mattphillipseng/GearboxAutomatedDesign/Excel Workbook/SolarImpulseFinalExcel_Group12.xlsx

Sheet: Strengths
Total Flight Time |  |  |  |  |  | Material We Use
Hours given |  | 118 |  |  |  | Material | Steel
Days |  | 4.916666667 |  |  |  | Class | A1-A5 |  | Daily Flight Cycle
Days rounded up |  | 5 |  |  |  | Material Designation | 2.5% Chrome |  | Operation | Hour | Time | RPM | Cycles/Hour | Cycles (cumulative
hours in 5 days |  | 120 |  |  |  | Heat Treatment | Nitrided |  | Take-Off | 1 | 6am-7am | 4000 | 240000 | 240000
 |  |  |  |  |  | Min Surf Hardness | 87.5-90.0 15N |  | Steep Climb | 2 | 7am-6pm | 3180 | 190800 | 430800
Assume Take-off for entire time |  |  |  |  |  | Bending Fatigue Strength Sfb' | 450 | [Mpa] |  | 3 |  | 3180 | 190800 | 621600
Takeoff RPM |  |  | 4000 |  |  | Surface Fatigue Strength Sfc' | 1500 | [Mpa] |  | 4 |  | 3180 | 190800 | 812400
contacts per rev |  |  | 1 |  |  |  |  |  |  | 5 |  | 3180 | 190800 | 1003200
revs per hour |  |  | 240000 |  |  |  |  |  |  | 6 |  | 3180 | 190800 | 1194000
contacts per hour |  |  | 240000 |  |  |  |  |  |  | 7 |  | 3180 | 190800 | 1384800
total contacts |  |  | 28800000 |  |  |  |  |  |  | 8 |  | 3180 | 190800 | 1575600
 |  |  |  |  |  |  |  |  |  | 9 |  | 3180 | 190800 | 1766400
Bending Fatigue Strength |  |  |  |  |  |  |  |  |  | 10 |  | 3180 | 190800 | 1957200
Factor | G2 | G3 | G4 | G5 | Notes |  |  |  |  | 11 |  | 3180 | 190800 | 2148000
KL | 0.94087 | 0.97203 | 0.97203 | 1.01158 | From table |  |  |  |  | 12 |  | 3180 | 190800 | 2338800
TF | 104 | 104 | 104 | 104 | °F |  |  |  | Gliding | 13 | 6pm-10pm | 0 | 0 | 2338800
KT | 0.9096774194 | 0.9096774194 | 0.9096774194 | 0.9096774194 | calculated |  |  |  |  | 14 |  | 0 | 0 | 2338800
KR | 1 | 1 | 1 | 1 | 99.00% |  |  |  |  | 15 |  | 0 | 0 | 2338800
Sfb | 465.4325007 | 480.843731 | 480.843731 | 500.4069377 | MPa MAX |  |  |  |  | 16 |  | 0 | 0 | 2338800
 |  |  |  |  |  |  |  |  | Steady Altitude | 17 | 10pm-6am | 2555 | 153300 | 2492100
Surface Fatigue Strength |  |  |  |  |  |  |  |  |  | 18 |  | 2555 | 153300 | 2645400
Factor | G2 | G3 | G4 | G5 | Notes |  |  |  |  | 19 |  | 2555 | 153300 | 2798700
CL | 0.84537 | 0.88660 | 0.88660 | 0.93894 | From table |  |  |  |  | 20 |  | 2555 | 153300 | 2952000
TF | 104 | 104 | 104 | 104 | °F |  |  |  |  | 21 |  | 2555 | 153300 | 3105300
CT | 0.9096774194 | 0.9096774194 | 0.9096774194 | 0.9096774194 | calculated |  |  |  |  | 22 |  | 2555 | 153300 | 3258600
CR | 1 | 1 | 1 | 1 | 99.00% |  |  |  |  | 23 |  | 2555 | 153300 | 3411900
CH | 1 | 1 | 1 | 1 | hardness factor |  |  |  |  | 24 |  | 2555 | 153300 | 3565200
Sfc | 1393.959405 | 1461.950127 | 1461.950127 | 1548.258392 | MPa MAX |  |  |  |  |  |  |  | Avg cycle/hour | 148550 | each tooth hit once in a revolution
 |  |  |  |  |  |  |  |  |  |  |  |  | x2000 hrs | 297100000
 |  |  |  |  |  |  |  |  |  |  |  |  | TOTAL CYCLES | 297100000 | 118840000 | 118840000 | 37137500
 |  |  |  |  |  |  |  |  |  |  |  |  |  | G2 | G3 | G4 | G5
 |  |  |  |  |  |  |  |  |  |  |  |  | Num Teeth | 18 | 45 | 20 | 64 | 8

Sheet: Gear Specs
Gear | 2 | 3 | 4 | 5
Teeth | 18 | 45 | 20 | 64
Module (mm) | 3 | 3 | 3 | 3
Face Width (mm) | 24 | 24 | 35 | 35
Pressure Angle | 20 | 20 | 20 | 20
Bending Safety Factor | 2.362 | 2.284 | 1.525 | 1.459
Surface Saftey Factor | 1.49 | 3.371 | 1.083 | 3.03
Pitch Diam | 54 | 135 | 60 | 192
Outer Diam | 60 | 141 | 66 | 198
total size | 295.5

Sheet: K_L and C_L
KL
x | y | CL
10000000 | 1.05 | 1.6042
10000000000 | 0.8125
Textbook Table
"12-24" | p756
 |  | This section was made form the textbook graphs to automate finding KL and CL, and so we can put this into MATLAB. ALSO, i did this before i realized there were equations on the charts in the book. I don't know how i didn't see that. The values they give are almost identical, so not a big deal.
CL
x | y
10000000 | 1 | KL
10000000000 | 0.69 | 1.7233
Textbook Table
"12-26" | p759

Sheet: Shafts
Forces |  |  |  | (input shaft)
 |  |  |  | Shaft 1 | Value | Units | Note
Gear 2 | Value | Units | Note | Total effective length | 70 | mm
 |  |  |  | dist from left bearing to gear | 27.5 | mm |  | Values
Volume | 5.276636e-05 | m3 |  | dist from gear to right bearing | 42.5 | mm |  | Steel density | 7.8 | Mg/m^3
Mass | 0.41 | kg
Weight | 4.037576334 | N | Upper bound | Right bearing reaction | 1102.606438 | N
Pitch diameter | 54 | mm |  | Left bearing reaction | 1704.028131 | N
 |  |  |  |  |  |  |  | Conversion factors
Power | 29827.99488 | W |  |  |  |  |  | mm^3 to m^3 | 1000000000
RPM | 4000 | rev/min |  |  |  |  |  | hp to W | 745.699872
Omega | 418.8790205 | rad/s |  |  |  |  |  | RPM to rad/s | 0.1047197551
Torque | 71.20909242 | N m
Wt | 2637.373793 | N
Wr | 959.9255573
W | 2806.634568
Gear 3 | Value | Units | Note | Shaft 2 | Value | Units | Note
Volume | 0.00033861109 | m3 |  | Total effective length | 206 | mm
Mass | 2.641166502 | kg |  | dist from left bearing to left gear | 35 | mm
Weight | 25.90984338 | N | Upper bound - without hollow gear | distance from left gear to right gear | 130.5 | mm
Pitch diameter | 135 | mm |  | distance from right gear to right bearing | 40.5 | mm
Power | 29827.99488 | W |  | Right bearing reaction | 5550.256103
RPM | 1600 | rev/min |  | Left bearing reaction | 3571.306244
Omega | 167.5516082 | rad/s
Torque | 178.022731 | N m
Wt | 2637.373793 | N
Wr | 959.9255573
W | 2806.634568
Gear 4 | Value | Units
Volume | 9.546012e-05 | m3
Mass | 0.744588936 | kg
Weight | 7.304417462 | N | Upper bound - without hollow gear
Pitch diameter | 60 | mm
Power | 29827.99488 | W
RPM | 1600 | rev/min
Omega | 167.5516082 | rad/s
Torque | 178.022731 | N m
Wt | 5934.091035 | N
Wr | 2159.832504
W | 6314.927779
 |  |  |  | Output shaft
Gear 5 | Value | Unit | Note | Shaft 3 | Value | Units | Note
Volume | 0.00100338005 | m3 |  | Total effective length | 91 | mm
Mass | 7.82636439 | kg |  | dist from left bearing to gear | 53 | mm
Weight | 76.77663467 | N | Upper bound - without hollow gear | dist from gear to right bearing | 38 | mm
Pitch diameter | 192 | mm
 |  |  |  | Right bearing reaction | 3677.92497 | N
Power | 29827.99488 | W |  | Left bearing reaction | 2637.002809 | N
RPM | 500 | rev/min
Omega | 52.35987756 | rad/s
Torque | 569.6727393 | N m
Wt | 5934.091035 | N
Wr | 2159.832504 | N
W | 6314.927779 | N

Sheet: Shafts Diagrams
 |  |  |  | Steel with
Shaft 1
 |  |  |  | At stress conc. 1 |  |  |  |  | At Max moment |  |  |  |  | At stress conc. 2 |  |  |  |  | At stress conc. 3
 |  |  |  | x | = | 15 |  |  | x | = | 27.5 |  |  | x | = | 40 |  |  | x | = | 55
 |  |  |  | Parameters |  |  |  |  | Parameters |  |  |  |  | Parameters |  |  |  |  | Parameters
 |  |  |  | kf | = | 1.299 |  |  | kf | = | 1 |  |  | kf | = | 1.368 |  |  | kf | = | 1.1104
 |  |  |  | Ma | = | 25560.42196 |  |  | Ma | = | 46860.7736 |  |  | Ma | = | 33078.19313 |  |  | Ma | = | 16539.09656
 | x | (V) | Note | kfsm | = | 1.138 |  |  | kfsm | = | 1 |  |  | kfsm | = | 1.138 |  |  | kfsm | = | 1.253
 | 0 | 1704.028131 |  | Tm | = | 71.20909242 |  |  | Tm | = | 71.20909242 |  |  | Tm | = | 0 |  |  | Tm | = | 0
 | 15 | 1704.028131 | Stress Concentration | Se | = | 562 |  |  | Se | = | 562 |  |  | Se | = | 562 |  |  | Se | = | 562
 | 27.5 | 1704.028131 |  | Sut | = | 1124 |  |  | Sut | = | 1124 |  |  | Sut | = | 1124 |  |  | Sut | = | 1124
 | 27.5 | -1102.606438
 | 40 | -1102.606438 |  |  | d | = | 20 |  |  | d | = | 25 |  |  | d | = | 25 |  |  | d | = | 20
 | 55 | -1102.606438 |  |  | D/d | = | 1.25 |  |  | D/d | = | 0 |  |  | D/d | = | 1.2 |  |  | D/d | = | 1.5
 | 70 | -1102.606438 |  |  | r/d | = | 0.25 |  |  | r/d | = | 0 |  |  | r/d | = | 0.2 |  |  | r/d | = | 0.5
 |  |  |  |  | Kt_bend | = | 1.325 |  |  | Kt_bend | = | 0 |  |  | Kt_bend | = | 1.4 |  |  | Kt_bend | = | 1.12
 |  |  |  |  | Kt_tors | = | 1.15 |  |  | Kt_tors | = | 0 |  |  | Kt_tors | = | 1.15 |  |  | Kt_tors | = | 1.275
 |  |  |  |  | yields… |  |  |  |  | yields… |  |  |  |  | yields… |  |  |  |  | yields…
 |  |  |  |  | Nf | = | 8.869917651 |  |  | Nf | = | 12.27771189 |  |  | Nf | = | 12.71932927 |  |  | Nf | = | 16.04614865
 |  |  |  |  |  |  | note
 |  |  |  |  | Steel option | AISI 1050 | Quench and temper @ 400deg F
 |  |  |  |  | SUT | 1124
 | x | M | Note |  | q | 0.92
 | 0 | 0 |  |  | Se | 562 | Sut < 1400 => Se = 0.5Sut
 | 15 | 25560.42196
 | 27.5 | 46860.7736 |  |  | Se | 375.2080657
 | 40 | 33078.19313
 | 55 | 16539.09656 |  |  | Cload | 1
 | 70 | 0 |  |  | Csize | 0.8891641518
 |  |  |  |  | Csurf | 0.9224216765
 |  |  |  |  | Ctemp | 1
 |  |  |  |  | Creliab | 0.814
 | x | T | Note
 | 0 | 71.20909242
 | 15 | 71.20909242
 | 27.5 | 71.20909242
 | 27.5 | 0
 | 40 | 0
 | 55 | 0
 | 70 | 0
Shaft 2
 |  |  |  |  | At stress conc. 1 |  |  |  |  | At stress conc. 2 |  |  |  |  | At stress conc. 3 |  |  |  |  | At Max moment |  |  |  | At stress conc. 4
Left bearing force |  | 3571.306244 |  |  | x | = | 22.5 |  |  | x | = | 47.5 |  |  | x | = | 147.5 |  |  | x | = | 165.5 |  | x | = | 183.5
left gear force |  | 2806.634568 |  |  | Parameters |  |  |  |  | Parameters |  |  |  |  | Parameters |  |  |  |  | Parameters |  |  |  | Parameters
right gear force |  | 6314.927779 |  |  | kf | = | 1.414 |  |  | kf | = | 1.46 |  |  | kf | = | 1.46 |  |  | kf | = | 1 |  | kf | = | 1.414
right bearing force |  | 5550.256103 |  |  | Ma | = | 80354.39049 |  |  | Ma | = | 134554.1145 |  |  | Ma | = | 211021.282 |  |  | Ma | = | 224785.3722 |  | Ma | = | 124880.7623
 |  |  |  |  | kfsm | = | 1.1288 |  |  | kfsm | = |  |  |  | kfsm | = | 1.138 |  |  | kfsm | = | 1 |  | kfsm | = | 1.1288
 |  |  |  |  | Tm | = | 0 |  |  | Tm | = | 178.022731 |  |  | Tm | = | 178.022731 |  |  | Tm | = | 0 |  | Tm | = | 356.0454621
 | x | V |  |  | Se' | = | 562 |  |  | Se' | = | 562 |  |  | Se' | = | 562 |  |  | Se' | = | 562 |  | Se' | = | 562
 | 0 | 3571.306244 |  |  | Sut | = | 1124 |  |  | Sut | = | 1124 |  |  | Sut | = | 1124 |  |  | Sut | = | 1124 |  | Sut | = | 1124
 | 22.5 | 3571.306244
 | 35 | 3571.306244 |  |  |  | d | = | 32 |  |  | d | = | 37 |  |  | d | = | 37 |  |  | d | = | 42 |  | d | = | 32
 | 35 | 764.6716755 |  |  |  | D/d | = | 1.15625 |  |  | D/d | = | 1.135 |  |  | D/d | = | 1.135 |  |  | D/d | = | 1 |  | D/d | = | 1.15625
 | 47.5 | 764.6716755 |  |  |  | r/d | = | 0.15625 |  |  | r/d | = | 0.135 |  |  | r/d | = | 0.135 |  |  | r/d | = | 0 |  | r/d | = | 0.15625
 | 147.5 | 764.6716755 |  |  |  | Kt_bend | = | 1.45 |  |  | Kt_bend | = | 1.5 |  |  | Kt_bend | = | 1.5 |  |  | Kt_bend | = | 1 |  | Kt_bend | = | 1.45
 | 165.5 | 764.6716755 |  |  |  | Kt_tors | = | 1.14 |  |  | Kt_tors | = | 1.15 |  |  | Kt_tors | = | 1.15 |  |  | Kt_tors | = | 1 |  | Kt_tors | = | 1.14
 | 165.5 | -5550.256103 |  |  |  | yields… |  |  |  |  | yields… |  |  |  |  | yields… |  |  |  |  | yields… |  |  |  | yields…
 | 183.5 | -5550.256103 |  |  |  | Nf | = | 9.56920341 |  |  | Nf | = | 8.555397767 |  |  | Nf | = | 5.454394344 |  |  | Nf | = | 10.93615601 |  | Nf | = | 6.154134694
 | 206 | -5550.256103
 | 206 | 0 |  |  |  |  |  | note
 |  |  |  |  |  | Steel option | AISI 1050 | Quench and temper @ 400deg F
 | x | M |  |  |  | SUT | 1124
 | 0 | 0 |  |  |  | q | 0.92
 | 22.5 | 80354.39049 |  |  |  | Se | 562 | Sut < 1400 => Se = 0.5Sut
 | 35 | 124995.7185
 | 47.5 | 134554.1145
 | 147.5 | 211021.282 |  |  |  | Se | 337.975312
 | 165.5 | 224785.3722
 | 183.5 | 124880.7623 |  |  |  | Cload | 1
 | 206 | -1.309672371e-10 |  |  |  | Csize | 0.8495370161
 |  |  |  |  |  | Csurf | 0.8696448922
 |  |  |  |  |  | Ctemp | 1
 | x | T |  |  |  | Creliab | 0.814
 | 0 | 0
 | 22.5 | 0
 | 35 | 0
 | 35 | 178.022731
 | 47.5 | 178.022731
 | 147.5 | 178.022731
 | 165.5 | 178.022731
 | 165.5 | 356.0454621
 | 183.5 | 356.0454621
 | 206 | 356.0454621
 | 206 | 0
Shaft 3
Left bearing force |  | 2637.002809
right bearing force |  | 3677.92497
gear force |  | 6314.927779
 |  |  |  |  | At stress conc. 1 |  |  |  |  | At stress conc. 2 |  |  |  |  | At Max moment |  |  |  |  | At stress conc. 3
 |  |  |  |  | x | = | 20 |  |  | x | = | 35 |  |  | x | = | 53 |  |  | x | = | 71
 |  |  |  |  | Parameters |  |  |  |  | Parameters |  |  |  |  | Parameters |  |  |  |  | Parameters
 |  |  |  |  | kf | = | 1.1656 |  |  | kf | = | 1.414 |  |  | kf | = | 1 |  |  | kf | = | 1.345
 |  |  |  |  | Ma | = | 52740.05618 |  |  | Ma | = | 92295.09831 |  |  | Ma | = | 139761.1489 |  |  | Ma | = | 73558.4994
 |  |  |  |  | kfsm | = | 1.092 |  |  | kfsm | = | 1.138 |  |  | kfsm | = | 1 |  |  | kfsm | = | 1.161
 |  |  |  |  | Tm | = | 0 |  |  | Tm | = | 0 |  |  | Tm | = | 0 |  |  | Tm | = | 569.6727393
 |  |  |  |  | Se | = | 562 |  |  | Se | = | 562 |  |  | Se | = | 562 |  |  | Se | = | 562
 |  |  |  |  | Sut | = | 1124 |  |  | Sut | = | 1124 |  |  | Sut | = | 1124 |  |  | Sut | = | 1124
 |  |  |  |  |  | d | = | 25 |  |  | d | = | 35 |  |  | d | = | 30 |  |  | d | = | 25
 |  |  |  |  |  | D/d | = | 1.4 |  |  | D/d | = | 1.16 |  |  | D/d | = |  |  |  | D/d | = | 1.2
 |  |  |  |  |  | r/d | = | 0.4 |  |  | r/d | = | 0.16 |  |  | r/d | = |  |  |  | r/d | = | 0.2
 | x | V |  |  |  | Kt_bend | = | 1.18 |  |  | Kt_bend | = | 1.45 |  |  | Kt_bend | = |  |  |  | Kt_bend | = | 1.375
 | 0 | 2637.002809 |  |  |  | Kt_tors | = | 1.1 |  |  | Kt_tors | = | 1.15 |  |  | Kt_tors | = |  |  |  | Kt_tors | = | 1.175
 | 20 | 2637.002809 |  |  |  | yields… |  |  |  |  | yields… |  |  |  |  | yields… |  |  |  |  | yields…
 | 35 | 2637.002809 |  |  |  | Nf | = | 9.932811365 |  |  | Nf | = | 12.83862091 |  |  | Nf | = | 7.54952436 |  |  | Nf | = | 6.160794592
 | 53 | 2637.002809
 | 53 | -3677.92497
 | 71 | -3677.92497 |  |  |  |  |  | note
 | 91 | -3677.92497 |  |  |  | Steel option | AISI 1050 | Quench and temper @ 400deg F
 | 91 | 0 |  |  |  | SUT | 1124
 |  |  |  |  |  | q | 0.92
 |  |  |  |  |  | Se | 562 | Sut < 1400 => Se = 0.5Sut
 |  |  |  |  |  | Se | 398.0543683
 | x | M |  |  |  | Cload | 1
 | 0 | 0 |  |  |  | Csize | 0.8701250541
 | 20 | 52740.05618 |  |  |  | Csurf | 1 | >1
 | 35 | 92295.09831 |  |  |  | Ctemp | 1
 | 53 | 139761.1489 |  |  |  | Creliab | 0.814
 | 71 | 73558.4994
 | 91 | 0
 | x | T
 | 0 | 0
 | 20 | 0
 | 35 | 0
 | 53 | 0
 | 53 | 569.6727393
 | 71 | 569.6727393
 | 91 | 569.6727393

Sheet: Bearings
 | Ball bearing: |  |  |  |  |  |  |  |  | K_R | = | 0.21 | 99% reliab
 |  |  |  |  |  |  |  |  |  | L_P | =
 | Roller Bearing:
 | FOR ROLLER BEARINGS
 |  | Bearings Shaft 1 | Note | Bearings Shaft 2 | Note | Bearings Shaft 3 (normal one) | Note | Bearings Shaft 3 (thrust bearing) | Note
input | Reaction 1 | 1.7040281 |  | 5.55
input | Reaction 2
 | Max Reaction | 1.7040281 |  | 5.55 |  | 2.637 | reaction at left | 3.677 | reaction at right
input | C | 28.5 | KN | 45.1 | KN | 38.1 | newtons | 74.1 | newtons
 | F_radial | 1.7040281 | from max reaction | 5.55 | from max reaction | 2.637 | from max reaction | 3.677 | max reaction
 | F_a (thrust) | 0 | no thrust | 0 | no thrust | 0 | no thrust | 6.672
input | X |  |  |  |  |  |  | 0.4
 | V | 1 |  | 1 |  | 1 |  | 1
input | Y |  |  |  |  |  |  | 2
calculation | P | 1.7040281 |  | 5.55 |  | 2.637 |  | 14.8148
 | K_R | 0.21 |  | 1 |  | 0.21 |  | 1.07
 | L_P minimum | 1782.0 |  | 714.0 |  | 222.6 |  | 222.6
 | L_P | 2512.540018 |  | 1078.810577 |  | 1542.654893 |  | 228.9769826 | should be at least L_P min
 | (20mm)Cylindrical Roller single row NUP204ECP |  |  | (32mm)Tappered Roller single row 320/32X |  | (25mm)Tappered Roller single row 30205 |  | (25mm) Tappered Roller single row 32305
 | C_0 = 22KN |  |  | C_0 = 45.1KN |  | C_0 = 33.5KN |  | C_0 = 63KN
 | S_L =19000 |  |  | S_L=11000 |  | S_L=13000 |  | S_L=12000
 | Cycles for each bearing
 |  | Shaft 1 | Shaft 2 |  | Shaft 3
 | 2000 hrs | 297000000 | 119000000 | 119000000 | 37100000
 | 6000 hrs | 1782000000 | 714000000 | 714000000 | 222600000
 | 6000 hrs in millions of cycles | 1782.0 | 714.0 | 714.0 | 222.6
 | from strengths sheet
