mattphillipseng/GearboxAutomatedDesign/CAD 393/G4.SLDASM

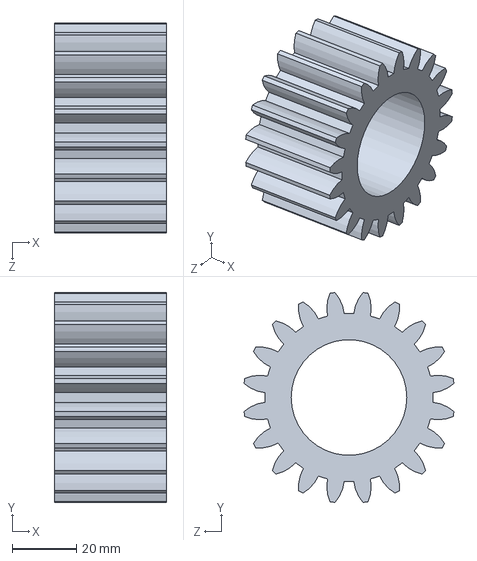
[picture p20: CAD file, 2018-02-15]
CAD 393/G4.SLDASM
35.0 x 65.4 x 65.4 mm
