mattphillipseng/GearboxAutomatedDesign/CAD 393/G3.SLDASM

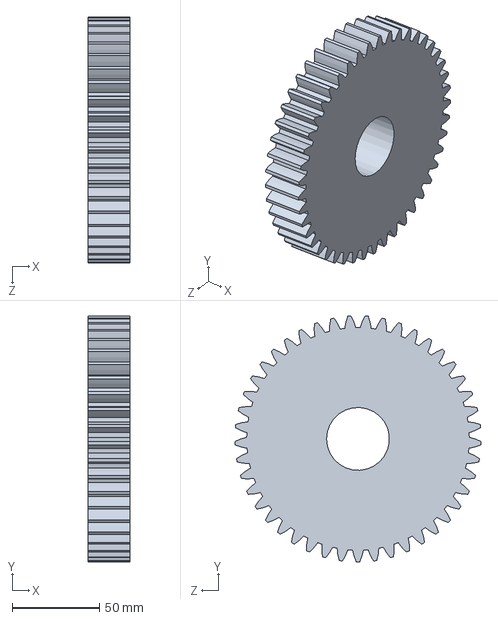
[picture p21: CAD file, 2018-02-15]
CAD 393/G3.SLDASM
24.0 x 140.9 x 141.0 mm
