mattphillipseng/GearboxAutomatedDesign/CAD 393/G5.SLDASM

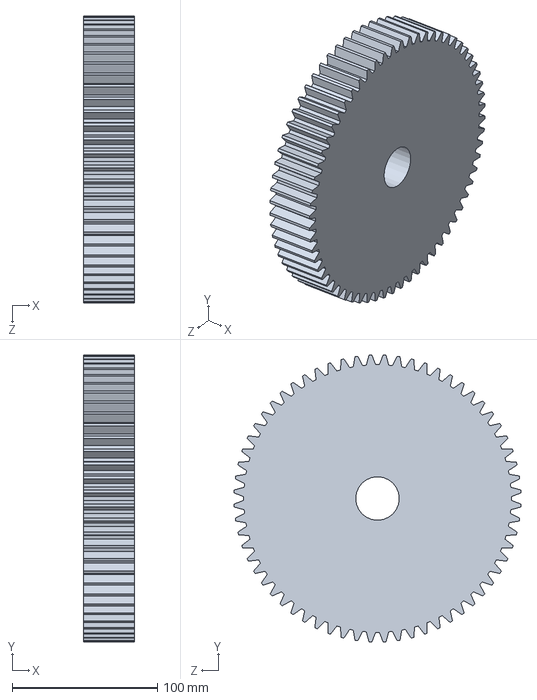
[picture p22: CAD file, 2018-02-15]
CAD 393/G5.SLDASM
35.0 x 197.8 x 197.8 mm
