mattphillipseng/GearboxAutomatedDesign/CAD 393/G2.SLDASM

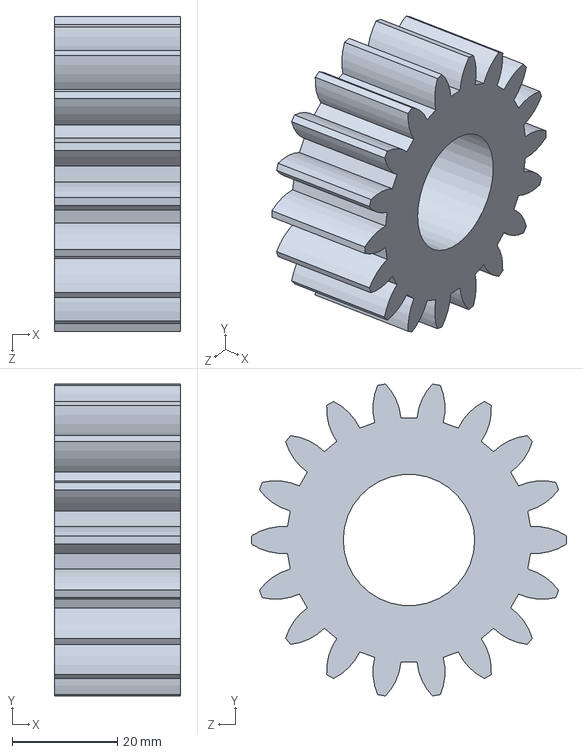
[picture p23: CAD file, 2018-02-15]
CAD 393/G2.SLDASM
24.0 x 59.3 x 60.0 mm
