mattphillipseng/GearboxAutomatedDesign/CAD 393/FULL2.SLDASM

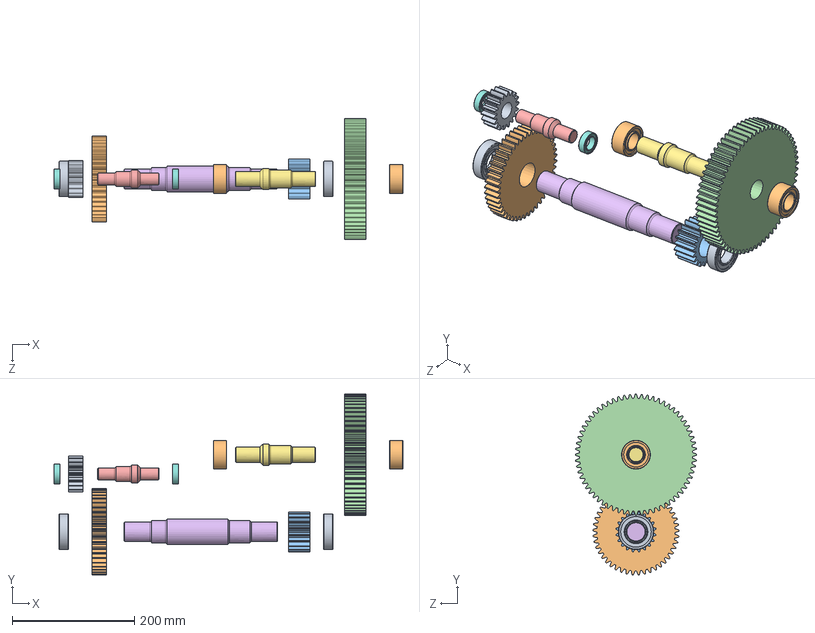
[picture p24: CAD file, 2018-02-15]
CAD 393/FULL2.SLDASM
570.0 x 295.4 x 198.0 mm
G2
G3
G4
G5
Shaft1
Shaft2
Shaft3
AFBMA 20.1 - 38-20 - 20,SI,NC,20 x 2
AFBMA 20.1 - 20-32 - 16,SI,NC,16 x 2
AFBMA 20.1 - 40-25 - 16,SI,NC,16 x 2
