mattphillipseng/GearboxAutomatedDesign/CAD 393/Shaft1.SLDPRT

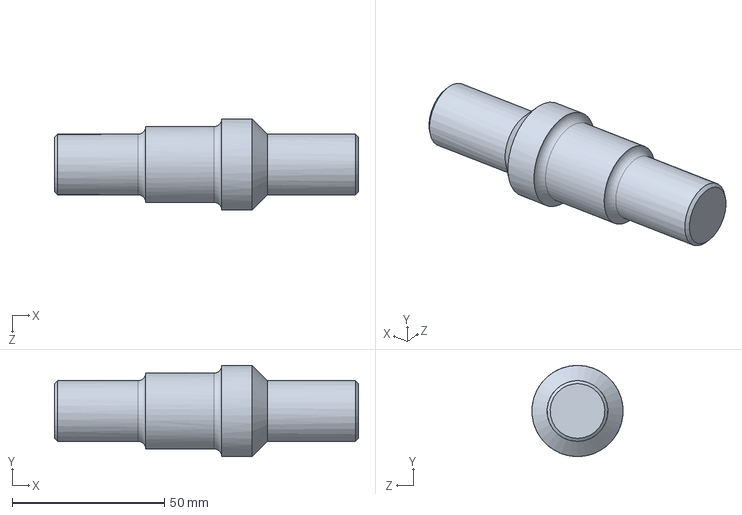
[picture p25: CAD file, 2018-02-15]
CAD 393/Shaft1.SLDPRT
100.0 x 30.0 x 30.0 mm
