mattphillipseng/GearboxAutomatedDesign/CAD 393/Shaft3.SLDPRT

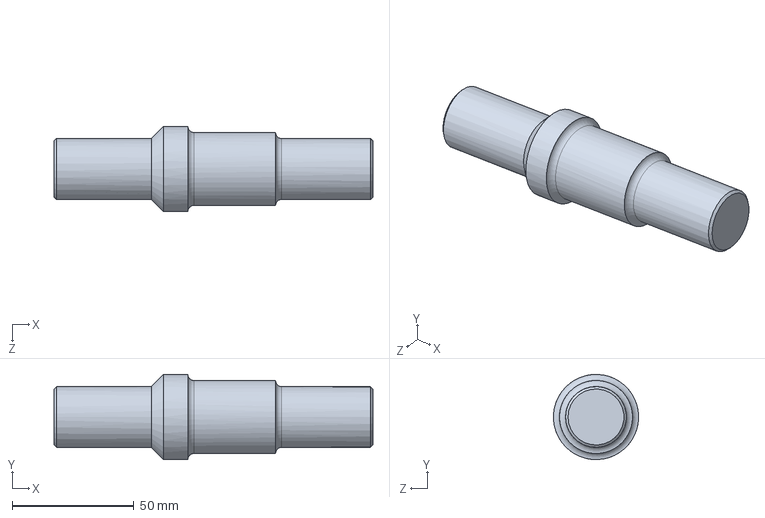
[picture p26: CAD file, 2018-02-15]
CAD 393/Shaft3.SLDPRT
131.0 x 35.0 x 35.0 mm
