mattphillipseng/GearboxAutomatedDesign/CAD 393/Shaft2.SLDPRT

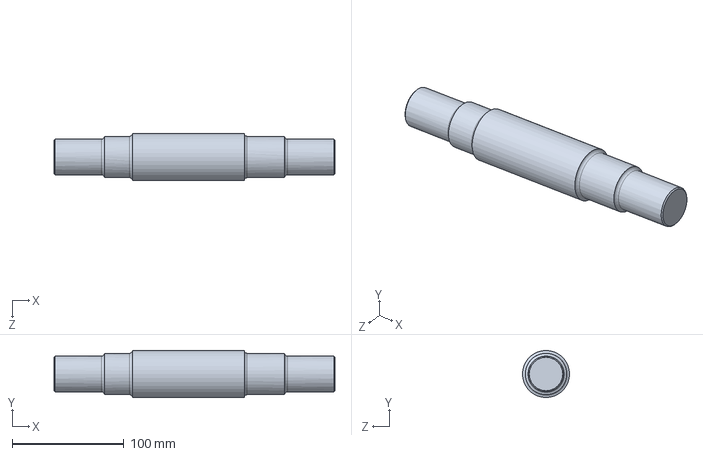
[picture p27: CAD file, 2018-02-15]
CAD 393/Shaft2.SLDPRT
251.0 x 42.0 x 42.0 mm
