mattphillipseng/GearboxAutomatedDesign/(list of files, cad)

Other CAD files:
CAD 393/G2.SLDPRT
CAD 393/G3.SLDPRT
CAD 393/G4.SLDPRT
CAD 393/G5.SLDPRT
CAD 393/drawings/AssemblyDrawing.SLDDRW
CAD 393/drawings/G2.SLDDRW
CAD 393/drawings/G3.SLDDRW
CAD 393/drawings/G4.SLDDRW
CAD 393/drawings/G5.SLDDRW
CAD 393/drawings/Shaft1.SLDDRW
CAD 393/drawings/Shaft2.SLDDRW
CAD 393/drawings/Shaft3.SLDDRW
